SantiagoAlasia/TPI-EDIII/esquematicos/Diseño-PCB-EDIII/Diseño-PCB-EDIII.kicad_sch

## KiCad design esquematicos/Diseño-PCB-EDIII/Diseño-PCB-EDIII.kicad_sch (2025-11-24, an earlier design)

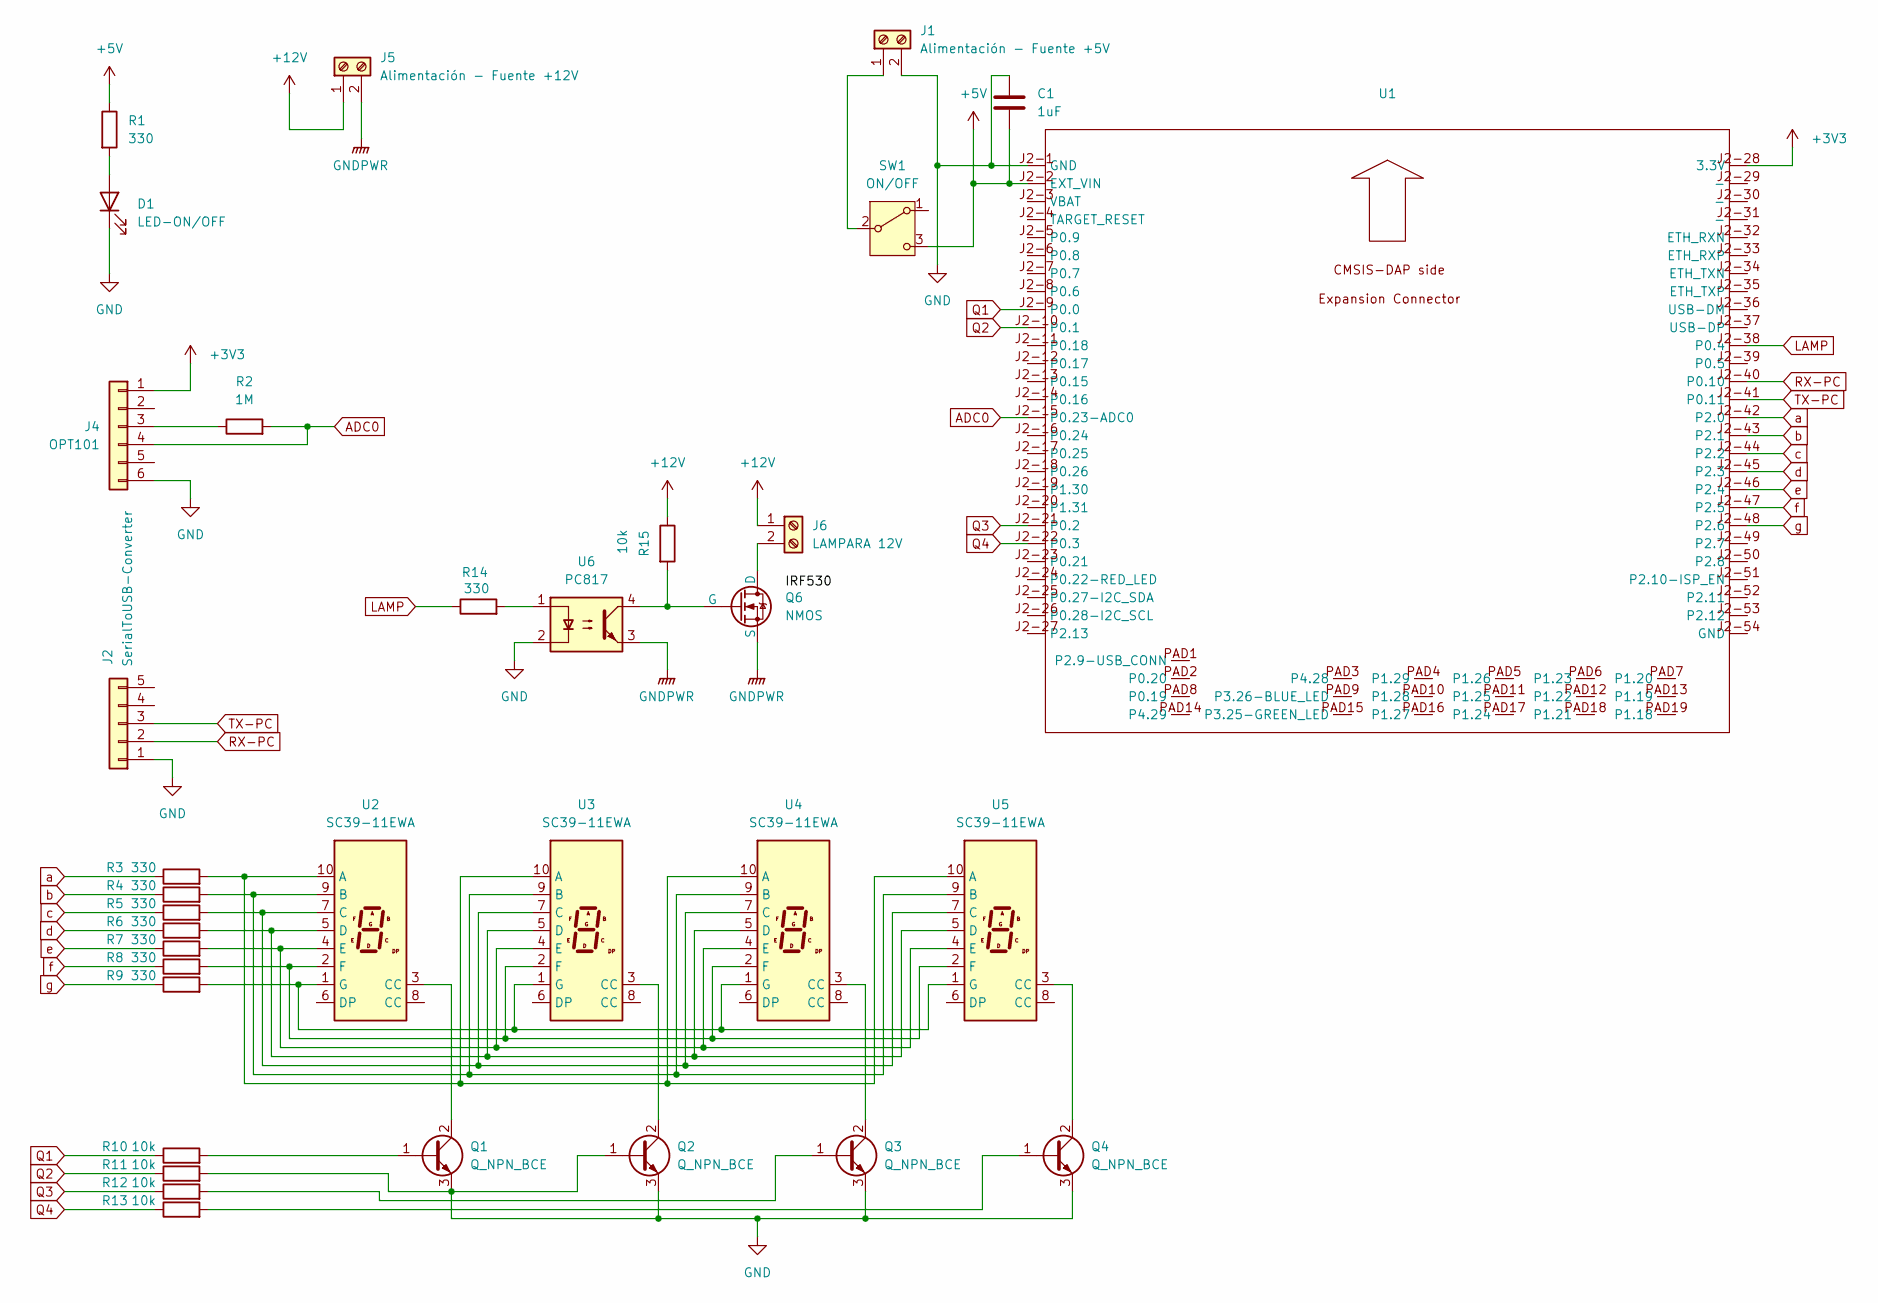
[picture p35: schematic Diseño-PCB-EDIII.kicad_sch]

Parts:
C1: 1uF
D1: LED-ON/OFF
J1: Alimentación - Fuente +5V
J2: SerialToUSB-Converter
J4: OPT101
J5: Alimentación - Fuente +12V
J6: LAMPARA 12V
Q1, Q2, Q3, Q4: Q_NPN_BCE
Q6: NMOS
R1, R3, R4, R5, R6, R7, R8, R9, R14: 330
R2: 1M
R10, R11, R12, R13, R15: 10k
SW1: ON/OFF
U1: (no value)
U2, U3, U4, U5: SC39-11EWA; Sx39-1xxxxx
U6: PC817; DIP-4_W7.62mm

Connections:
+3V3: J4.1, U1.J2-28 (3.3V)
+5V: C1.1, R1.1, SW1.3 (C), U1.J2-2 (EXT_VIN)
+12V: J5.1, J6.1, R15.1
ADC0: J4.4, R2.2, U1.J2-15 (P0.23-ADC0)
GND: C1.2, D1.1 (K), J1.2, J2.1, J4.6, Q1.3 (E), Q2.1 (B), Q2.3 (E), Q3.3 (E), Q4.3 (E), R11.2, U1.J2-1 (GND), U6.2
GNDPWR: J5.2, Q6.3 (S), U6.3
LAMP: R14.1, U1.J2-38 (P0.4)
unnamed: D1.2 (A), R1.2
unnamed: J1.1, SW1.2 (B)
unnamed: J4.3, R2.1
unnamed: J6.2, Q6.1 (D)
unnamed: Q1.1 (B), R10.2
unnamed: Q1.2 (C), U2.3 (CC)
unnamed: Q2.2 (C), U3.3 (CC)
unnamed: Q3.1 (B), R12.2
unnamed: Q3.2 (C), U4.3 (CC)
unnamed: Q4.1 (B), R13.2
unnamed: Q4.2 (C), U5.3 (CC)
unnamed: Q6.2 (G), R15.2, U6.4
unnamed: R3.2, U2.10 (A), U3.10 (A), U4.10 (A), U5.10 (A)
unnamed: R4.2, U2.9 (B), U3.9 (B), U4.9 (B), U5.9 (B)
unnamed: R5.2, U2.7 (C), U3.7 (C), U4.7 (C), U5.7 (C)
unnamed: R6.2, U2.5 (D), U3.5 (D), U4.5 (D), U5.5 (D)
unnamed: R7.2, U2.4 (E), U3.4 (E), U4.4 (E), U5.4 (E)
unnamed: R8.2, U2.2 (F), U3.2 (F), U4.2 (F), U5.2 (F)
unnamed: R9.2, U2.1 (G), U3.1 (G), U4.1 (G), U5.1 (G)
unnamed: R14.2, U6.1
Q1: R10.1, U1.J2-9 (P0.0)
Q2: R11.1, U1.J2-10 (P0.1)
Q3: R12.1, U1.J2-21 (P0.2)
Q4: R13.1, U1.J2-22 (P0.3)
RX-PC: J2.2, U1.J2-40 (P0.10)
TX-PC: J2.3, U1.J2-41 (P0.11)
a: R3.1, U1.J2-42 (P2.0)
b: R4.1, U1.J2-43 (P2.1)
c: R5.1, U1.J2-44 (P2.2)
d: R6.1, U1.J2-45 (P2.3)
e: R7.1, U1.J2-46 (P2.4)
f: R8.1, U1.J2-47 (P2.5)
g: R9.1, U1.J2-48 (P2.6)
