SantiagoAlasia/TPI-EDIII/(commit log)

2025-11-07 Esquematico + Codigo inicial
    [Diseño-PCB-EDIII.kicad_pcb, Diseño-PCB-EDIII.kicad_sch]
2025-11-18 Version Funcionando + Interfaz grafica actualizada + adicionales para la calibracion
    [Diseño-PCB-EDIII.kicad_sch]
